Gekkotron/WaterHeaterController/README.md

# WaterHeaterController
The Water Heater Controller is a smart IoT device that allows remote control of your water heater's power via MQTT over Ethernet. Users can adjust power from 0% to 100%, monitor water temperature, set heating schedules, and track energy consumption. It includes safety features like over-temperature and overload protection for reliable operation.

# Version Mai 2025 with STM32F103RET6 (512Ko)




# Version Février of pcb with STM32F103RET6 (512Ko)


# R&D of pcb with STM32F103RET6 (512Ko)
