Gekkotron/WaterHeaterController/R&D/ZeroCrossing/Schematic.png

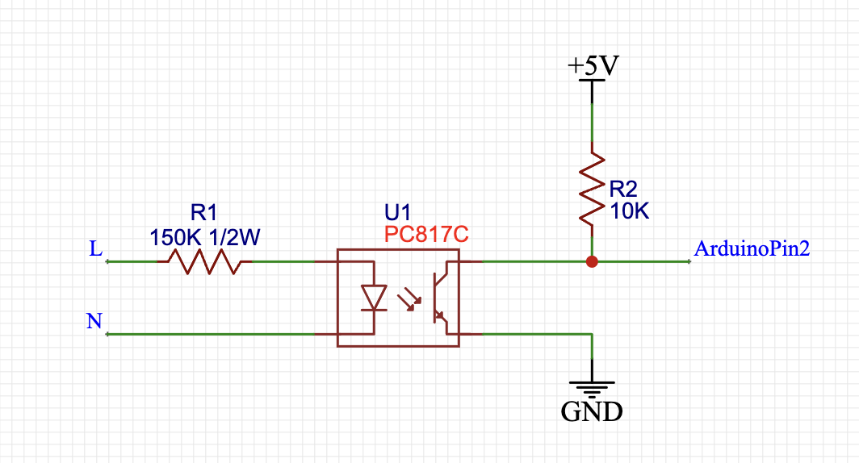
R&D/ZeroCrossing/Schematic.png
