Gekkotron/WaterHeaterController/R&D/ZeroCrossing/PrintSignal/Signal.png

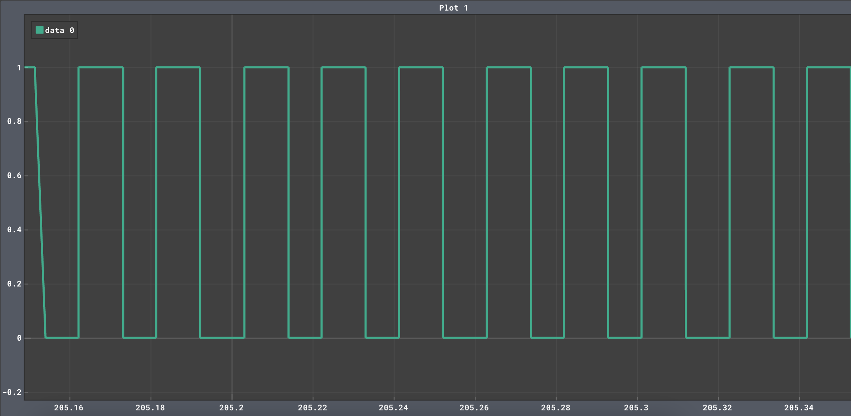
R&D/ZeroCrossing/PrintSignal/Signal.png
