Gekkotron/WaterHeaterController/R&D/ZeroCrossing/MeasureFrequency/Serial output.png

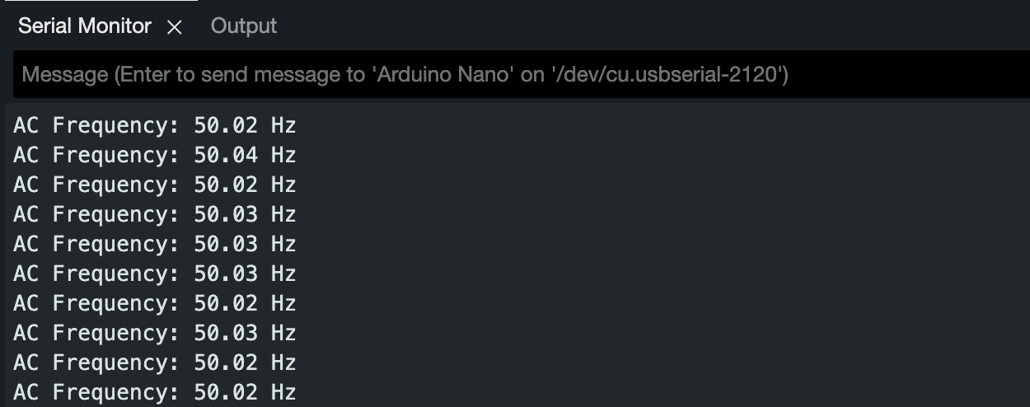
R&D/ZeroCrossing/MeasureFrequency/Serial output.png
