Gekkotron/WaterHeaterController/app/WaterHeaterController/src/main.cpp

#include <Arduino.h>
#include "config.h"
#include "ethernet_manager.h"
#include "temp.h"
#include "water_sensor.h"
#include "power_control.h"
#include "app.h"
#include "mqtt.h"
#include "logger.h"
#include "analog.h"
#include "ota_update.h"

#if defined(__AVR__)
#include <avr/wdt.h>
#endif

void setup()
{
  #if defined(__AVR__)
  // Disable watchdog first (in case of WDT reset, WDT stays enabled)
  wdt_disable();
  #endif

  //HAL_Init();
  logger_begin();

  ethernet_setup();
  ota_setup();
  mqtt_setup();
  power_control_setup();
  //water_sensor_setup();
  adc_setup();

  pinMode(LedPin, OUTPUT); // Initialize the LED pin as an output
  digitalWrite(LedPin, HIGH);

  delay(2000);

  #if defined(__AVR__)
  // Enable 8-second watchdog — board resets if loop() hangs
  wdt_enable(WDTO_8S);
  #endif
}

void updatePower(uint8_t channel, uint8_t power)
{
  sprintf(buffer, "Channel %d Power %d", channel, power);
  logger_println(buffer);
  setTriacPower(channel, power);
}

unsigned long lastBlink = 0;
void loop()
{
  #if defined(__AVR__)
  wdt_reset(); // Feed the watchdog — must complete full loop within 8s
  #endif

  ota_loop();
  ethernet_loop();
  mqtt_loop();
  comms_watchdog_check(); // force reset if network/W5100 is dead
  adc_loop();
  DS18B20_loop();
  publishData();
  publishHeartbeat();
  checkPowerTimeout();

  // led blinking
#if defined(__STM32F1__) || defined(__STM32__)
  if (HAL_GetTick() - lastBlink > 500) {
      lastBlink = HAL_GetTick();
#elif defined(__AVR__)
  if (millis() - lastBlink > 500) {
      lastBlink = millis();
#endif
      digitalWrite(LedPin, !digitalRead(LedPin));

      /*
      digitalWrite(triac_pin_1, HIGH);
      digitalWrite(triac_pin_2, LOW);
      digitalWrite(triac_pin_3, LOW);
      */

#if defined(__STM32F1__) || defined(__STM32__)
      JsonDocument document = createJsonData();
      rtt.print("JSON: ");
      serializeJson(document, rtt);
      rtt.println();
#endif
  }
}
