Gekkotron/WaterHeaterController/(commit log)

2024-11-25 Add water sensor and power control
2026-02-22 Add reset_cause in string
    [config.h]
2026-05-30 Use internal 1.1V ADC reference with multi-sampling
    AVCC reference was noisy (volatile AREF), making readings inaccurate.
    Switch AVR to the stable on-chip 1.1V bandgap reference, average
    ADC_SAMPLES reads on both platforms, and add getAdcVoltageMv() with
    overflow-safe 32-bit math.
2026-05-30 Add comms watchdog to recover from W5100 lockups
    The hardware watchdog only catches code hangs, but the device hung at
    the network layer (reset_cause=poweron, heartbeats stopped, MCU alive)
    while loop() kept feeding the WDT. Force a reset if no MQTT publish
    succeeds within NETWORK_TIMEOUT so the W5100 re-initialises on its own
    instead of needing a manual power cycle.
    [main.cpp, mqtt.h]
2026-05-30 Cap DHCP timeout and guard STM32-only pin init on AVR
    Ethernet.begin(mac) could block up to 60s on DHCP failure, exceeding
    the 8s watchdog; cap it at 5s. The PB3/4/5 pinMode init is for STM32
    SPI pins only — on AVR those resolve to digital pins 3/4/5 (water
    sensor, OneWire bus, triac 1), so guard it behind the STM32 macro.
    [ethernet_manager.h]
